marcocampione/Hem-keyboard/pcb/hem_bom.csv

Item | Designator | Qty | Manufacturer | Mfg Part # | Description / Value | Package | Side | Type
1 | RGB1,RGB2,RGB3,RGB4,RGB5,RGB6,RGB7,RGB8,RGB9,RGB10,RGB11,RGB12,RGB13,RGB14,RGB15,RGB16,RGB17,RGB18,RGB19,RGB20,RGB21,RGB22,RGB23,RGB24,RGB25,RGB26,RGB27,RGB28,RGB29,RGB30,RGB31,RGB32,RGB33,RGB34,RGB35,RGB36,RGB37,RGB38,RGB39,RGB40,RGB41,RGB42,RGB43,RGB44,RGB45,RGB46,RGB47,RGB48,RGB49,RGB50,RGB51,RGB52,RGB53,RGB54,RGB55,RGB56,RGB57,RGB58,RGB59,RGB60,RGB61,RGB62,RGB63,RGB64,RGB65,RGB66,RGB67 | 67 | OPSCO | SK6812MINI-E | SK6812MINI-E: RGB LED, REVERSE MOUNT on the back (lens through the PCB cutout) | LED_SK6812MINI-E_3.2x2.8mm_P1.5mm_ReverseMount | bottom | SMD
2 | D1,D2,D3,D4,D5,D6,D7,D8,D9,D10,D11,D12,D13,D14,D15,D16,D17,D18,D19,D20,D21,D22,D23,D24,D25,D26,D27,D28,D29,D30,D31,D32,D33,D34,D35,D36,D37,D38,D39,D40,D41,D42,D43,D44,D45,D46,D47,D48,D49,D50,D51,D52,D53,D54,D55,D56,D57,D58,D59,D60,D61,D62,D63,D64,D65,D66,D67 | 67 | Diodes Inc | 1N4148W-7-F | 1N4148W: switching diode SOD-123 | D_SOD-123 | bottom | SMD
3 | C1,C2,C3,C4,C5,C6,C7,C8,C9,C10,C15,C30,CL1,CL2,CL3,CL4,CL5,CL6,CL7,CL8,CL9,CL10,CL11,CL12,CL13,CL14,CL15,CL16,CL17,CL18,CL19,CL20,CL21,CL22,CL23,CL24,CL25,CL26,CL27,CL28,CL29,CL30,CL31,CL32,CL33,CL34,CL35,CL36,CL37,CL38,CL39,CL40,CL41,CL42,CL43,CL44,CL45,CL46,CL47,CL48,CL49,CL50,CL51,CL52,CL53,CL54,CL55,CL56,CL57,CL58,CL59,CL60,CL61,CL62,CL63,CL64,CL65,CL66,CL67 | 79 | Samsung | CL05B104KO5NNNC | 100nF: 100 nF 16 V X7R 0402 | C_0402_1005Metric | bottom | SMD
4 | Y1 | 1 | Abracon | ABM8-272-T3 | 12MHz: crystal 12 MHz 10 pF 3225 (RP2040 reference part) | Crystal_SMD_3225-4Pin_3.2x2.5mm | bottom | SMD
5 | C11,C12 | 2 | Samsung | CL05A105KA5NQNC | 1uF: 1 uF 25 V X5R 0402 | C_0402_1005Metric | bottom | SMD
6 | C31 | 1 | Samsung | CL10A226MP8NUNE | 22uF: 22 uF 10 V X5R 0603 | C_0603_1608Metric | bottom | SMD
7 | C13,C14 | 2 | Samsung | CL05C150JB5NNNC | 15pF: 15 pF 50 V C0G 0402 | C_0402_1005Metric | bottom | SMD
8 | C20,C21 | 2 | Samsung | CL10A106KO8NNNC | 10uF: 10 uF 16 V X5R 0603 | C_0603_1608Metric | bottom | SMD
9 | R5,R6 | 2 | Yageo | RC0402FR-0727RL | 27: 27 R 1% 0402 | R_0402_1005Metric | bottom | SMD
10 | J1 | 1 | JST | SM04B-SRSS-TB(LF)(SN) | uDB JST-SH: 4-pin 1 mm right-angle header (USB daughterboard) | JST_SH_SM04B-SRSS-TB_1x04-1MP_P1.00mm_Horizontal | bottom | SMD
11 | SW_RST | 1 | Omron | B3U-1000P | RESET: tactile switch, SMD | SW_SPST_B3U-1000P | bottom | SMD
12 | U3 | 1 | Winbond | W25Q128JVSIQ | W25Q128JVS: 16 MB QSPI flash, SOIC-8 208 mil | SOIC-8_5.3x5.3mm_P1.27mm | bottom | SMD
13 | R9,R10 | 2 | Yageo | RC0402FR-074K7L | 4.7k: 4.7 k 1% 0402 | R_0402_1005Metric | bottom | SMD
14 | U2 | 1 | Diodes Inc | AP2112K-3.3TRG1 | AP2112K-3.3: LDO 3.3 V 600 mA | SOT-23-5 | bottom | SMD
15 | U4 | 1 | Texas Instruments | SN74AHCT1G125DBVR | 74AHCT1G125: buffer, 3.3 V -> 5 V level shift for the LED data | SOT-23-5 | bottom | SMD
16 | R3,R4 | 2 | Yageo | RC0402FR-071KL | 1k: 1 k 1% 0402 | R_0402_1005Metric | bottom | SMD
17 | U1 | 1 | Raspberry Pi | RP2040 | RP2040: MCU, dual Cortex-M0+, QFN-56 7x7 | QFN-56-1EP_7x7mm_P0.4mm_EP3.2x3.2mm | bottom | SMD
18 | J2 | 1 | JST | SM04B-SRSS-TB(LF)(SN) | OLED I2C: 4-pin 1 mm right-angle header (OLED) | JST_SH_SM04B-SRSS-TB_1x04-1MP_P1.00mm_Horizontal | bottom | SMD
19 | SW_BOOT | 1 | Omron | B3U-1000P | BOOTSEL: tactile switch, SMD | SW_SPST_B3U-1000P | bottom | SMD
