marcocampione/Hem-keyboard/pcb/kicad/hem.kicad_pcb

## KiCad design pcb/kicad/hem.kicad_pcb (2026-10-13)

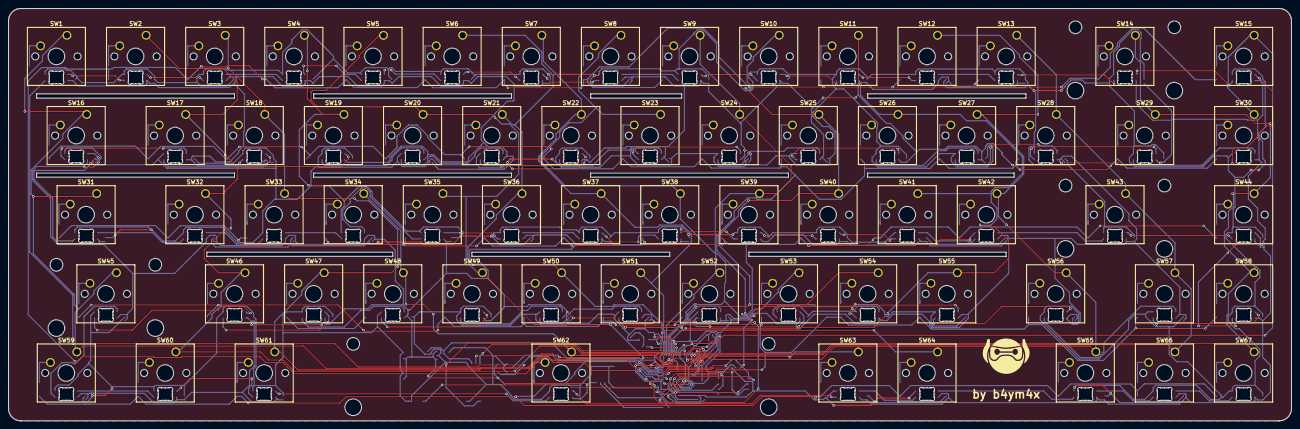
[picture p10: board hem.kicad_pcb from above]

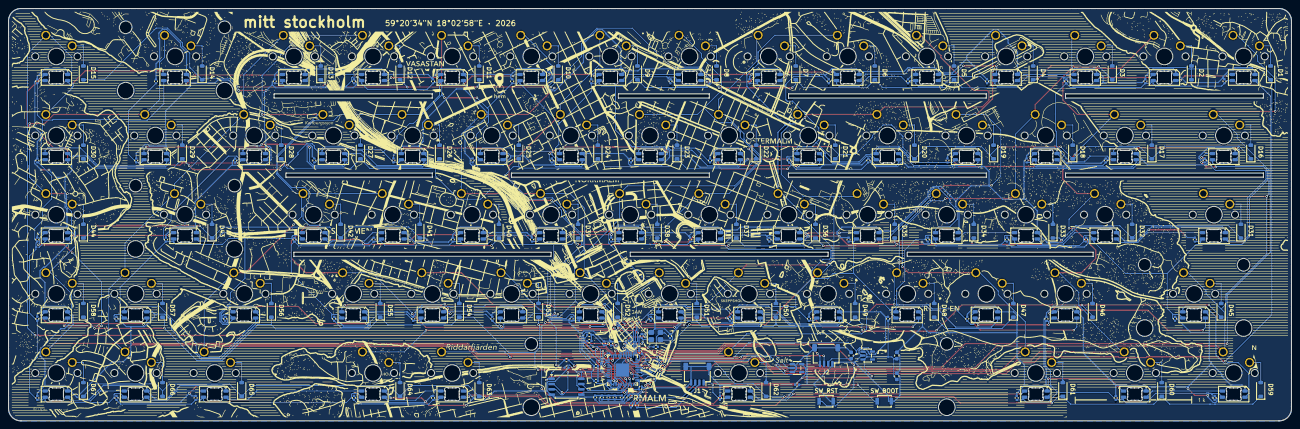
[picture p11: board hem.kicad_pcb from below]

Board: 2 copper layers, 308.8 x 99.2 mm, 302 parts (235 on the bottom side), 176 nets.

Parts:
C1, C2, C3, C4, C5, C6, C7, C8, C9, C10, C15, C30: 100nF; C_0402_1005Metric
C11, C12: 1uF; C_0402_1005Metric
C13, C14: 15pF; C_0402_1005Metric
C20, C21: 10uF; C_0603_1608Metric
C31: 22uF; C_0603_1608Metric
CL1, CL2, CL3, CL4, CL5, CL6, CL7, CL8, CL9, CL10, CL11, CL12, CL13, CL14, CL15, CL16, CL17, CL18, CL19, CL20, CL21, CL22, CL23, CL24, CL25, CL26, CL27, CL28, CL29, CL30, CL31, CL32, CL33, CL34, CL35, CL36, CL37, CL38, CL39, CL40, CL41, CL42, CL43, CL44, CL45, CL46, CL47, CL48, CL49, CL50, CL51, CL52, CL53, CL54, CL55, CL56, CL57, CL58, CL59, CL60, CL61, CL62, CL63, CL64, CL65, CL66, CL67: 100nF; C_0402_1005Metric
D1, D2, D3, D4, D5, D6, D7, D8, D9, D10, D11, D12, D13, D14, D15, D16, D17, D18, D19, D20, D21, D22, D23, D24, D25, D26, D27, D28, D29, D30, D31, D32, D33, D34, D35, D36, D37, D38, D39, D40, D41, D42, D43, D44, D45, D46, D47, D48, D49, D50, D51, D52, D53, D54, D55, D56, D57, D58, D59, D60, D61, D62, D63, D64, D65, D66, D67: 1N4148W; D_SOD-123
J1: uDB JST-SH; JST_SH_SM04B-SRSS-TB_1x04-1MP_P1.00mm_Horizontal
J2: OLED I2C; JST_SH_SM04B-SRSS-TB_1x04-1MP_P1.00mm_Horizontal
R3, R4: 1k; R_0402_1005Metric
R5, R6: 27; R_0402_1005Metric
R9, R10: 4.7k; R_0402_1005Metric
RGB1, RGB2, RGB3, RGB4, RGB5, RGB6, RGB7, RGB8, RGB9, RGB10, RGB11, RGB12, RGB13, RGB14, RGB15, RGB16, RGB17, RGB18, RGB19, RGB20, RGB21, RGB22, RGB23, RGB24, RGB25, RGB26, RGB27, RGB28, RGB29, RGB30, RGB31, RGB32, RGB33, RGB34, RGB35, RGB36, RGB37, RGB38, RGB39, RGB40, RGB41, RGB42, RGB43, RGB44, RGB45, RGB46, RGB47, RGB48, RGB49, RGB50, RGB51, RGB52, RGB53, RGB54, RGB55, RGB56, RGB57, RGB58, RGB59, RGB60, RGB61, RGB62, RGB63, RGB64, RGB65, RGB66, RGB67: SK6812MINI-E; LED_SK6812MINI-E_3.2x2.8mm_P1.5mm_ReverseMount
SW1: `; SW_Cherry_MX_1.00u_PCB
SW2: 1; SW_Cherry_MX_1.00u_PCB
SW3: 2; SW_Cherry_MX_1.00u_PCB
SW4: 3; SW_Cherry_MX_1.00u_PCB
SW5: 4; SW_Cherry_MX_1.00u_PCB
SW6: 5; SW_Cherry_MX_1.00u_PCB
SW7: 6; SW_Cherry_MX_1.00u_PCB
SW8: 7; SW_Cherry_MX_1.00u_PCB
SW9: 8; SW_Cherry_MX_1.00u_PCB
SW10: 9; SW_Cherry_MX_1.00u_PCB
SW11: 0; SW_Cherry_MX_1.00u_PCB
SW12: -; SW_Cherry_MX_1.00u_PCB
SW13: =; SW_Cherry_MX_1.00u_PCB
SW14: BSPC; SW_Cherry_MX_2.00u_PCB
SW15: DEL; SW_Cherry_MX_1.00u_PCB
SW16: TAB; SW_Cherry_MX_1.50u_PCB
SW17: Q; SW_Cherry_MX_1.00u_PCB
SW18: W; SW_Cherry_MX_1.00u_PCB
SW19: E; SW_Cherry_MX_1.00u_PCB
SW20: R; SW_Cherry_MX_1.00u_PCB
SW21: T; SW_Cherry_MX_1.00u_PCB
SW22: Y; SW_Cherry_MX_1.00u_PCB
SW23: U; SW_Cherry_MX_1.00u_PCB
SW24: I; SW_Cherry_MX_1.00u_PCB
SW25: O; SW_Cherry_MX_1.00u_PCB
SW26: P; SW_Cherry_MX_1.00u_PCB
SW27: [; SW_Cherry_MX_1.00u_PCB
SW28: ]; SW_Cherry_MX_1.00u_PCB
SW29: \; SW_Cherry_MX_1.50u_PCB
SW30: PGUP; SW_Cherry_MX_1.00u_PCB
SW31: CAPS; SW_Cherry_MX_1.75u_PCB
SW32: A; SW_Cherry_MX_1.00u_PCB
SW33: S; SW_Cherry_MX_1.00u_PCB
SW34: D; SW_Cherry_MX_1.00u_PCB
SW35: F; SW_Cherry_MX_1.00u_PCB
SW36: G; SW_Cherry_MX_1.00u_PCB
SW37: H; SW_Cherry_MX_1.00u_PCB
SW38: J; SW_Cherry_MX_1.00u_PCB
SW39: K; SW_Cherry_MX_1.00u_PCB
SW40: L; SW_Cherry_MX_1.00u_PCB
SW41: ;; SW_Cherry_MX_1.00u_PCB
SW42: '; SW_Cherry_MX_1.00u_PCB
SW43: ENT; SW_Cherry_MX_2.25u_PCB
SW44: PGDN; SW_Cherry_MX_1.00u_PCB
SW45: LSFT; SW_Cherry_MX_2.25u_PCB
SW46: Z; SW_Cherry_MX_1.00u_PCB
SW47: X; SW_Cherry_MX_1.00u_PCB
SW48: C; SW_Cherry_MX_1.00u_PCB
SW49: V; SW_Cherry_MX_1.00u_PCB
SW50: B; SW_Cherry_MX_1.00u_PCB
SW51: N; SW_Cherry_MX_1.00u_PCB
SW52: M; SW_Cherry_MX_1.00u_PCB
SW53: ,; SW_Cherry_MX_1.00u_PCB
SW54: .; SW_Cherry_MX_1.00u_PCB
SW55: /; SW_Cherry_MX_1.00u_PCB
SW56: RSFT; SW_Cherry_MX_1.75u_PCB
SW57: UP; SW_Cherry_MX_1.00u_PCB
SW58: END; SW_Cherry_MX_1.00u_PCB
SW59: LCTL; SW_Cherry_MX_1.25u_PCB
SW60: LGUI; SW_Cherry_MX_1.25u_PCB
SW61: LALT; SW_Cherry_MX_1.25u_PCB
SW62: SPC; SW_Cherry_MX_6.25u_PCB
SW63: RALT; SW_Cherry_MX_1.00u_PCB
SW64: FN; SW_Cherry_MX_1.00u_PCB
SW65: LEFT; SW_Cherry_MX_1.00u_PCB
SW66: DOWN; SW_Cherry_MX_1.00u_PCB
SW67: RGHT; SW_Cherry_MX_1.00u_PCB
SW_BOOT: BOOTSEL; SW_SPST_B3U-1000P
SW_RST: RESET; SW_SPST_B3U-1000P
U1: RP2040; QFN-56-1EP_7x7mm_P0.4mm_EP3.2x3.2mm
U2: AP2112K-3.3; SOT-23-5
U3: W25Q128JVS; SOIC-8_5.3x5.3mm_P1.27mm
U4: 74AHCT1G125; SOT-23-5
Y1: 12MHz; Crystal_SMD_3225-4Pin_3.2x2.5mm

Connections:
1V1: C6.1, C8.1, C12.1, U1.23, U1.45, U1.50
3V3: C1.1, C2.1, C3.1, C4.1, C5.1, C7.1, C9.1, C10.1, C11.1, C15.1, C21.1, J2.2, R9.2, R10.2, U1.1, U1.10, U1.22, U1.33, U1.42, U1.43, U1.44, U1.48, U1.49, U2.5, U3.8
BOOT: R4.2, SW_BOOT.1
COL0: SW1.1, SW16.1, SW31.1, SW45.1, SW59.1, U1.7
COL1: SW2.1, SW17.1, SW32.1, SW46.1, SW60.1, U1.8
COL2: SW3.1, SW18.1, SW33.1, SW47.1, SW61.1, U1.9
COL3: SW4.1, SW19.1, SW34.1, SW48.1, SW62.1, U1.11
COL4: SW5.1, SW20.1, SW35.1, SW49.1, SW63.1, U1.12
COL5: SW6.1, SW21.1, SW36.1, SW50.1, SW64.1, U1.13
COL6: SW7.1, SW22.1, SW37.1, SW51.1, U1.14
COL7: SW8.1, SW23.1, SW38.1, SW52.1, U1.15
COL8: SW9.1, SW24.1, SW39.1, SW53.1, U1.16
COL9: SW10.1, SW25.1, SW40.1, SW54.1, U1.17
COL10: SW11.1, SW26.1, SW41.1, SW55.1, U1.18
COL11: SW12.1, SW27.1, SW42.1, SW56.1, SW65.1, U1.27
COL12: SW13.1, SW28.1, SW43.1, SW57.1, SW66.1, U1.28
COL13: SW14.1, SW29.1, SW44.1, SW58.1, SW67.1, U1.29
COL14: SW15.1, SW30.1, U1.30
D1: D1.2, SW1.2
D2: D2.2, SW2.2
D3: D3.2, SW3.2
D4: D4.2, SW4.2
D5: D5.2, SW5.2
D6: D6.2, SW6.2
D7: D7.2, SW7.2
D8: D8.2, SW8.2
D9: D9.2, SW9.2
D10: D10.2, SW10.2
D11: D11.2, SW11.2
D12: D12.2, SW12.2
D13: D13.2, SW13.2
D14: D14.2, SW14.2
D15: D15.2, SW15.2
D16: D16.2, SW16.2
D17: D17.2, SW17.2
D18: D18.2, SW18.2
D19: D19.2, SW19.2
D20: D20.2, SW20.2
D21: D21.2, SW21.2
D22: D22.2, SW22.2
D23: D23.2, SW23.2
D24: D24.2, SW24.2
D25: D25.2, SW25.2
D26: D26.2, SW26.2
D27: D27.2, SW27.2
D28: D28.2, SW28.2
D29: D29.2, SW29.2
D30: D30.2, SW30.2
D31: D31.2, SW31.2
D32: D32.2, SW32.2
D33: D33.2, SW33.2
D34: D34.2, SW34.2
D35: D35.2, SW35.2
D36: D36.2, SW36.2
D37: D37.2, SW37.2
D38: D38.2, SW38.2
D39: D39.2, SW39.2
D40: D40.2, SW40.2
D41: D41.2, SW41.2
D42: D42.2, SW42.2
D43: D43.2, SW43.2
D44: D44.2, SW44.2
D45: D45.2, SW45.2
D46: D46.2, SW46.2
D47: D47.2, SW47.2
D48: D48.2, SW48.2
D49: D49.2, SW49.2
D50: D50.2, SW50.2
D51: D51.2, SW51.2
D52: D52.2, SW52.2
D53: D53.2, SW53.2
D54: D54.2, SW54.2
D55: D55.2, SW55.2
D56: D56.2, SW56.2
D57: D57.2, SW57.2
D58: D58.2, SW58.2
D59: D59.2, SW59.2
D60: D60.2, SW60.2
D61: D61.2, SW61.2
D62: D62.2, SW62.2
D63: D63.2, SW63.2
D64: D64.2, SW64.2
D65: D65.2, SW65.2
D66: D66.2, SW66.2
D67: D67.2, SW67.2
GND: C1.2, C2.2, C3.2, C4.2, C5.2, C6.2, C7.2, C8.2, C9.2, C10.2, C11.2, C12.2, C13.2, C14.2, C15.2, C20.2, C21.2, C30.2, C31.2, CL1.2, CL2.2, CL3.2, CL4.2, CL5.2, CL6.2, CL7.2, CL8.2, CL9.2, CL10.2, CL11.2, CL12.2, CL13.2, CL14.2, CL15.2, CL16.2, CL17.2, CL18.2, CL19.2, CL20.2, CL21.2, CL22.2, CL23.2, CL24.2, CL25.2, CL26.2, CL27.2, CL28.2, CL29.2, CL30.2, CL31.2, CL32.2, CL33.2, CL34.2, CL35.2, CL36.2, CL37.2, CL38.2, CL39.2, CL40.2, CL41.2, CL42.2, CL43.2, CL44.2, CL45.2, CL46.2, CL47.2, CL48.2, CL49.2, CL50.2, CL51.2, CL52.2, CL53.2, CL54.2, CL55.2, CL56.2, CL57.2, CL58.2, CL59.2, CL60.2, CL61.2, CL62.2, CL63.2, CL64.2, CL65.2, CL66.2, CL67.2, J1.4, J1.MP, J2.1, J2.MP, RGB1.1, RGB2.1, RGB3.1, RGB4.1, RGB5.1, RGB6.1, RGB7.1, RGB8.1, RGB9.1, RGB10.1, RGB11.1, RGB12.1, RGB13.1, RGB14.1, RGB15.1, RGB16.1, RGB17.1, RGB18.1, RGB19.1, RGB20.1, RGB21.1, RGB22.1, RGB23.1, RGB24.1, RGB25.1, RGB26.1, RGB27.1, RGB28.1, RGB29.1, RGB30.1, RGB31.1, RGB32.1, RGB33.1, RGB34.1, RGB35.1, RGB36.1, RGB37.1, RGB38.1, RGB39.1, RGB40.1, RGB41.1, RGB42.1, RGB43.1, RGB44.1, RGB45.1, RGB46.1, RGB47.1, RGB48.1, RGB49.1, RGB50.1, RGB51.1, RGB52.1, RGB53.1, RGB54.1, RGB55.1, RGB56.1, RGB57.1, RGB58.1, RGB59.1, RGB60.1, RGB61.1, RGB62.1, RGB63.1, RGB64.1, RGB65.1, RGB66.1, RGB67.1, SW_BOOT.2, SW_RST.2, U1.19, U1.57, U2.2, U3.4, U4.1, U4.3, Y1.2, Y1.4
LD0: RGB1.2, U4.4
LD1: RGB1.4, RGB2.2
LD2: RGB2.4, RGB3.2
LD3: RGB3.4, RGB4.2
LD4: RGB4.4, RGB5.2
LD5: RGB5.4, RGB6.2
LD6: RGB6.4, RGB7.2
LD7: RGB7.4, RGB8.2
LD8: RGB8.4, RGB9.2
LD9: RGB9.4, RGB10.2
LD10: RGB10.4, RGB11.2
LD11: RGB11.4, RGB12.2
LD12: RGB12.4, RGB13.2
LD13: RGB13.4, RGB14.2
LD14: RGB14.4, RGB15.2
LD15: RGB15.4, RGB30.2
LD16: RGB29.2, RGB30.4
LD17: RGB28.2, RGB29.4
LD18: RGB27.2, RGB28.4
LD19: RGB26.2, RGB27.4
LD20: RGB25.2, RGB26.4
LD21: RGB24.2, RGB25.4
LD22: RGB23.2, RGB24.4
LD23: RGB22.2, RGB23.4
LD24: RGB21.2, RGB22.4
LD25: RGB20.2, RGB21.4
LD26: RGB19.2, RGB20.4
LD27: RGB18.2, RGB19.4
LD28: RGB17.2, RGB18.4
LD29: RGB16.2, RGB17.4
LD30: RGB16.4, RGB31.2
LD31: RGB31.4, RGB32.2
LD32: RGB32.4, RGB33.2
LD33: RGB33.4, RGB34.2
LD34: RGB34.4, RGB35.2
LD35: RGB35.4, RGB36.2
LD36: RGB36.4, RGB37.2
LD37: RGB37.4, RGB38.2
LD38: RGB38.4, RGB39.2
LD39: RGB39.4, RGB40.2
LD40: RGB40.4, RGB41.2
LD41: RGB41.4, RGB42.2
LD42: RGB42.4, RGB43.2
LD43: RGB43.4, RGB44.2
LD44: RGB44.4, RGB58.2
LD45: RGB57.2, RGB58.4
LD46: RGB56.2, RGB57.4
LD47: RGB55.2, RGB56.4
LD48: RGB54.2, RGB55.4
LD49: RGB53.2, RGB54.4
LD50: RGB52.2, RGB53.4
LD51: RGB51.2, RGB52.4
LD52: RGB50.2, RGB51.4
LD53: RGB49.2, RGB50.4
LD54: RGB48.2, RGB49.4
LD55: RGB47.2, RGB48.4
LD56: RGB46.2, RGB47.4
LD57: RGB45.2, RGB46.4
LD58: RGB45.4, RGB59.2
LD59: RGB59.4, RGB60.2
LD60: RGB60.4, RGB61.2
LD61: RGB61.4, RGB62.2
LD62: RGB62.4, RGB63.2
LD63: RGB63.4, RGB64.2
LD64: RGB64.4, RGB65.2
LD65: RGB65.4, RGB66.2
LD66: RGB66.4, RGB67.2
QSPI_SCLK: U1.52, U3.6
QSPI_SD0: U1.53, U3.5
QSPI_SD1: U1.55, U3.2
QSPI_SD2: U1.54, U3.3
QSPI_SD3: U1.51, U3.7
QSPI_SS: R4.1, U1.56, U3.1
RGB_3V3: U1.31, U4.2
ROW0: D1.1, D2.1, D3.1, D4.1, D5.1, D6.1, D7.1, D8.1, D9.1, D10.1, D11.1, D12.1, D13.1, D14.1, D15.1, U1.2
ROW1: D16.1, D17.1, D18.1, D19.1, D20.1, D21.1, D22.1, D23.1, D24.1, D25.1, D26.1, D27.1, D28.1, D29.1, D30.1, U1.3
ROW2: D31.1, D32.1, D33.1, D34.1, D35.1, D36.1, D37.1, D38.1, D39.1, D40.1, D41.1, D42.1, D43.1, D44.1, U1.4
ROW3: D45.1, D46.1, D47.1, D48.1, D49.1, D50.1, D51.1, D52.1, D53.1, D54.1, D55.1, D56.1, D57.1, D58.1, U1.5
ROW4: D59.1, D60.1, D61.1, D62.1, D63.1, D64.1, D65.1, D66.1, D67.1, U1.6
RUN: SW_RST.1, U1.26
SCL: J2.3, R10.1, U1.39
SDA: J2.4, R9.1, U1.38
UDM: J1.2, R6.1
UDP: J1.3, R5.1
USB_DM: R6.2, U1.46
USB_DP: R5.2, U1.47
VBUS: C20.1, C30.1, C31.1, CL1.1, CL2.1, CL3.1, CL4.1, CL5.1, CL6.1, CL7.1, CL8.1, CL9.1, CL10.1, CL11.1, CL12.1, CL13.1, CL14.1, CL15.1, CL16.1, CL17.1, CL18.1, CL19.1, CL20.1, CL21.1, CL22.1, CL23.1, CL24.1, CL25.1, CL26.1, CL27.1, CL28.1, CL29.1, CL30.1, CL31.1, CL32.1, CL33.1, CL34.1, CL35.1, CL36.1, CL37.1, CL38.1, CL39.1, CL40.1, CL41.1, CL42.1, CL43.1, CL44.1, CL45.1, CL46.1, CL47.1, CL48.1, CL49.1, CL50.1, CL51.1, CL52.1, CL53.1, CL54.1, CL55.1, CL56.1, CL57.1, CL58.1, CL59.1, CL60.1, CL61.1, CL62.1, CL63.1, CL64.1, CL65.1, CL66.1, CL67.1, J1.1, RGB1.3, RGB2.3, RGB3.3, RGB4.3, RGB5.3, RGB6.3, RGB7.3, RGB8.3, RGB9.3, RGB10.3, RGB11.3, RGB12.3, RGB13.3, RGB14.3, RGB15.3, RGB16.3, RGB17.3, RGB18.3, RGB19.3, RGB20.3, RGB21.3, RGB22.3, RGB23.3, RGB24.3, RGB25.3, RGB26.3, RGB27.3, RGB28.3, RGB29.3, RGB30.3, RGB31.3, RGB32.3, RGB33.3, RGB34.3, RGB35.3, RGB36.3, RGB37.3, RGB38.3, RGB39.3, RGB40.3, RGB41.3, RGB42.3, RGB43.3, RGB44.3, RGB45.3, RGB46.3, RGB47.3, RGB48.3, RGB49.3, RGB50.3, RGB51.3, RGB52.3, RGB53.3, RGB54.3, RGB55.3, RGB56.3, RGB57.3, RGB58.3, RGB59.3, RGB60.3, RGB61.3, RGB62.3, RGB63.3, RGB64.3, RGB65.3, RGB66.3, RGB67.3, U2.1, U2.3, U4.5
XI: C13.1, U1.20, Y1.1
XO: R3.1, U1.21
XO2: C14.1, R3.2, Y1.3
